InsanityBy/SmartPublicBathroom/README.md

# 智能公共浴室管理系统  

## 项目情况介绍  
本部分将从**项目背景**、**项目功能**、**系统框架**和**系统指标**四个方面对智能公共浴室管理系统项目进行简略介绍。您在阅读后，将对本项目有最基本的认识，可以根据您的需求决定本项目是否适用。如需进一步获取项目情况，您可查看以下文件:  
`Project\0_Document\OpeningReport_SmartPublicBathroom.md`  

### 项目背景  

### 项目功能  
### 系统框架  
### 系统指标  
## 使用要求及方法  
### 使用要求  
### 使用方法  
## 成品效果展示  
## 文件结构说明
- `Project`目录下包含项目的开发文件
    - `Document`项目开发总体设计方案
    - `ShowerTerminal`淋浴器终端的开发文件
        - `Enclosure`外壳设计
            - `Document`设计文档
            - `Project`项目文件
            - `Reference`参考资料
        - `Hardware`硬件设计
            - `Document`设计文档
            - `Schematic`原理图
            - `PCB`PCB设计
            - `Lirary`符号库、封装库和3D模型库
            - `Reference`参考资料和数据手册
        - `Software`软件设计
            - `Document`设计文档
            - `Library`各模块库文件
            - `Project`项目文件和主程序
            - `Reference`参考资料
    - `ShowerHost`淋浴间主机的开发文件
        - 内部文件结构同`ShowerTerminal`
    - `Image`项目文档中的所有图片
    - `Reference`总体设计引用的参考资料
- `Report`目录下包含项目的汇报文件
    - `OpeningReport`开题报告相关文件
        - `Document`报告文档
        - `Image`报告中所有图片
        - `Presentation`报告幻灯片
        - `Reference`报告引用的参考资料
    - `DesignReview`设计审查相关文件
        - `Document`报告文档
        - `Image`报告中所有图片
        - `Presentation`报告幻灯片
    - `MidtermReview`中期审查相关文件
    - `FinalReport`结题报告相关文件
    - `Upload`每阶段提交的压缩文件
