InsanityBy/SmartPublicBathroom/Project/1_ShowerTerminal/Hardware/0_Document/Power_Design.md

# 电源设计  

## 修改历史  
|版本|日期|说明|作者|  
|----|----|----|----|
|V1.0|2022年4月11日|创建电源设计|马博阳|  
|V1.1|2022年4月11日|修改电源设计，输出±5V|马博阳|  
|V1.2|2022年4月16日|修改电源设计需求，强调强弱电隔离|马博阳|  
|V1.3|2022年4月20日|修改原理图，增加指示灯|马博阳|  

## 设计需求  
1. 输入为市电：220VAC；  
2. 输出为3路电源：±5VDC和3.3VDC；  
3. 强电和弱电隔离；  
4. 可以在浴室环境下正常工作，保证设备安全。  

## 电源电路设计  
为保证浴室环境内的用电安全，电路设计分为两部分：第一部分为AC-DC模块，将220V交流电转换为±5V直流电，低于潮湿环境人体安全电压12V，这一部分设置在模块外，可单独布置在浴室外；第二部分为直流稳压，在淋浴器终端和淋浴间主机内，对±5V直流输入滤波，并将+5V直流转换为3.3V直流并稳压。  
考虑到AC-DC模块有一定的安全问题，直接采用LM旗舰店提供的现有模块`RH-30W+5V/-5V`，该模块电气参数符合需求，并且为隔离变压器，实现了强弱电隔离。  
AC-DC  
淋浴器终端和淋浴间主机电源部分设计如下， 220μF和0.1μF电容并联，实现对±5V电源的滤波和去耦；`TLV1117`将+5V输出稳压至3.3V。  
Control&Drive_Schematic
