InsanityBy/SmartPublicBathroom/Project/2_ShowerHost/Software/0_Document/ShowerHost_Interrupt.md

# 淋浴间主机中断配置  

## 修改历史  
|版本|日期|说明|作者|  
|----|----|----|----|
|V1.0|2022年5月11日|创建淋浴间主机中断配置|马博阳|  

1. 按键消抖定时器中断，优先级0 - 0
2. 按键中断，优先级1 - 0
3. ZigBee串口接收中断， 优先级2 - 0
4. WiFi串口接收中断，优先级2 - 0
5. ADC采样中断，优先级3 - 0
