InsanityBy/SmartPublicBathroom/Project/1_ShowerTerminal/Software/0_Document/ShowerTerminal_Interrupt.md

# 淋浴器终端中断配置  

## 修改历史  
|版本|日期|说明|作者|  
|----|----|----|----|
|V1.0|2022年5月11日|创建淋浴器终端中断配置|马博阳|  

1. 按键消抖定时器中断，优先级0 - 0
2. 按键中断，优先级1 - 0
3. ADC采样中断，优先级2 - 0
4. 红外接收头中断，优先级2 - 0
