InsanityBy/SmartPublicBathroom/Project/Image/Background.png

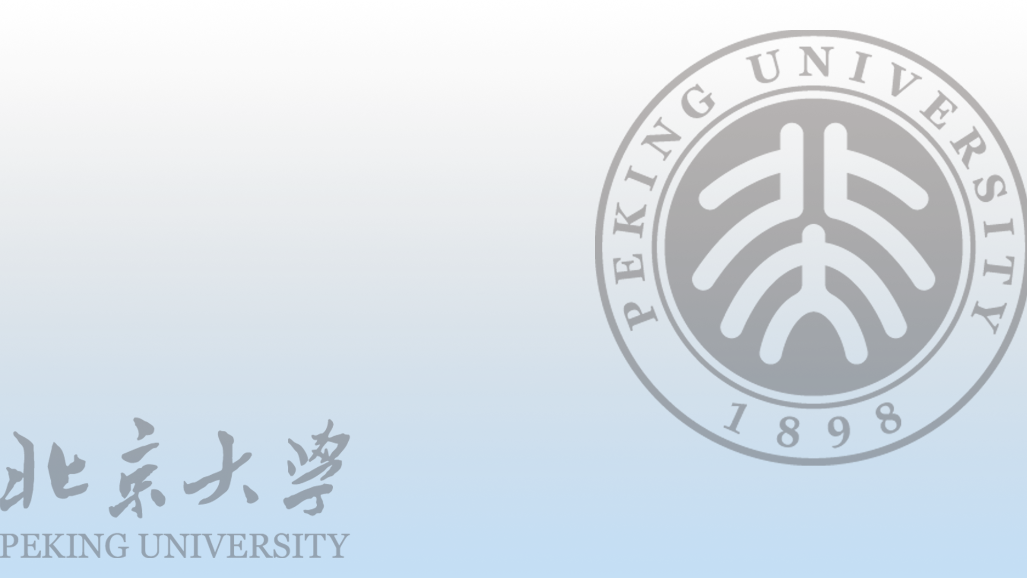
Project/Image/Background.png
