InsanityBy/SmartPublicBathroom/Project/0_Document/BOM.xlsx

序号 | 商品类型 | 商品名称 | 商品型号 | 封装格式 | 数量 | 总金额 | 商品编号 | 品牌
1 | 贴片电容(MLCC) | 100nF ±10% 50V | C0805B104K500NT | 0805 | 50 | ￥1.12 | C476766 | TORCH(火炬)
2 | 贴片型铝电解电容 | 220uF ±20% 10V | RVT1A221M0605 | SMD,6.3x5.4mm | 20 | ￥3.88 | C970694 | DMBJ(振宝佳)
3 | 贴片电容(MLCC) | 1uF ±20% 25V | TCC0805X5R105M250FT | 0805 | 50 | ￥1.80 | C713511 | CCTC(三环)
4 | 贴片电容(MLCC) | 47uF ±20% 6.3V | CL21A476MQYNNNG | 0805 | 10 | ￥2.30 | C913933 | SAMSUNG(三星)
5 | 贴片电容(MLCC) | 10uF ±10% 10V | CL21A106KPFNNNE | 0805 | 50 | ￥2.60 | C17024 | SAMSUNG(三星)
6 | 贴片电容(MLCC) | 20pF ±5% 100V | TCC0805COG200J101BT | 0805 | 50 | ￥2.49 | C696908 | CCTC(三环)
7 | 贴片电容(MLCC) | 15pF ±5% 50V | TCC0805COG150J500BT | 0805 | 50 | ￥1.54 | C376865 | CCTC(三环)
8 | 发光二极管 | 蓝灯 | NCD0805B2 | 0805 | 20 | ￥3.12 | C84259 | 国星光电
9 | 通用二极管 | 1kV 1A 1.1V@1A | 1N4007 | DO-41 | 20 | ￥2.27 | C2848132 | HORNBY ELECTRONIC(南通康比)
10 | 红外发射管 | F5发射管 Q等级 | DY-IR333C-A | Through Hole,P=2.54mm | 10 | ￥3.00 | C390046 | TONYU(东裕)
11 | 红外遥控接收头 | IRM-56384 | IRM-56384 | 插件 | 3 | ￥2.86 | C72048 | EVERLIGHT(台湾亿光)
12 | 温度传感器 | 数字温度圆线探头 | DS18B20A10 | 1M | 1 | ￥15.34 | C2938789 | UMW(友台半导体)
13 | 磁珠 | 30Ω@100MHz ±25% | FCM1608KF-300T07 | 0603 | 100 | ￥1.97 | C133930 | 台庆
14 | 环境光传感器 | 光敏传感器 | HLPT5I850HP25 | Through Hole | 5 | ￥3.38 | C559380 | JCHL(晶创和立)
15 | 三极管(BJT) | NPN 25V 500mA | S8050 | SOT-23(SOT-23-3) | 50 | ￥2.95 | C181158 | Hottech(合科泰)
16 | 光电三极管 | K等级 | DY-PT333-3B | ThroughHole | 10 | ￥3.52 | C396683 | TONYU(东裕)
17 | 功率继电器 | 功率继电器 10A250VAC | 973-5VDC-SL-A | 插件 | 3 | ￥6.17 | C396949 | NHLC(汇龙仓)
18 | 贴片电阻 | 1kΩ ±1% 125mW | AECR0805F1K00K9 | 0805 | 50 | ￥1.31 | C328385 | RESI(开步睿思）
19 | 贴片电阻 | 0Ω | FRC0805P000 TS | 0805 | 100 | ￥0.84 | C2907288 | FOJAN(富捷)
20 | 贴片电阻 | 1.8kΩ ±1% 0.125W | RMS10FT1801 | 0805 | 50 | ￥1.35 | C912582 | 台湾大毅
21 | 贴片电阻 | 100Ω ±5% 125mW | FRC0805J101 TS | 0805 | 100 | ￥0.84 | C2907294 | FOJAN(富捷)
22 | 贴片电阻 | 220Ω ±5% 1/8W | FRC0805J221TSD | 0805 | 100 | ￥0.80 | C2930259 | FOJAN(富捷)
23 | 贴片电阻 | 11kΩ ±5% 125mW | 0805W8J0113T5E | 0805 | 100 | ￥1.10 | C25614 | UNI-ROYAL(厚声)
24 | 贴片电阻 | 100kΩ ±5% 125mW | RC0805JR-07100KL | 0805 | 100 | ￥0.98 | C100049 | YAGEO(国巨)
25 | 贴片电阻 | 3.9kΩ ±5% 1/8W | FRC0805J392TS | 0805 | 100 | ￥0.86 | C2930268 | FOJAN(富捷)
26 | 贴片电阻 | 10kΩ ±5% 1/8W | FRC0805J103TS | 0805 | 100 | ￥0.95 | C2930231 | FOJAN(富捷)
27 | 贴片电阻 | 620Ω ±5% 1/8W | FRC0805J621 TSD | 0805 | 100 | ￥0.85 | C2933560 | FOJAN(富捷)
28 | 贴片电阻 | 91kΩ ±1% 1/8W | FRC0805F9102TS | 0805 | 100 | ￥1.09 | C2933509 | FOJAN(富捷)
29 | 贴片电阻 | 27kΩ ±5% 1/8W | FRC0805J273TS | 0805 | 100 | ￥0.84 | C2930263 | FOJAN(富捷)
30 | 贴片电阻 | 330kΩ ±5% 125mW | RS-05K334JT | 0805 | 100 | ￥0.88 | C294705 | FH(风华)
31 | 贴片电阻 | 9.1kΩ ±5% 125mW | FRC0805J912 TS | 0805 | 100 | ￥0.80 | C2907345 | FOJAN(富捷)
32 | 贴片电阻 | 8.2kΩ ±1% 1/8W | FRC0805F8201TS | 0805 | 100 | ￥1.02 | C2933503 | FOJAN(富捷)
33 | 贴片电阻 | 51kΩ ±5% 1/8W | FRC0805J513TS | 0805 | 100 | ￥0.80 | C2930300 | FOJAN(富捷)
34 | 贴片电阻 | 330Ω ±5% 1/8W | FRC0805J331TSD | 0805 | 100 | ￥0.85 | C2930274 | FOJAN(富捷)
35 | 线性稳压器(LDO) | Vin=5.5V Vout=3.3V 1A 75dB@(120Hz) | TLV1117LV33DCYR | SOT-223 | 2 | ￥4.42 | C15578 | TI(德州仪器)
36 | 精密运放 | TLV2374IDR | TLV2374IDR | SOIC-14_150mil | 2 | ￥22.36 | C29793 | TI(德州仪器)
37 | 湿敏/温湿度传感器 | 数字温湿度模块12mm*15.5mm*5.9mm | DHT21 | 插件 | 1 | ￥10.26 | C2880290 | HAIGU(广州海谷)
38 | 音频接口芯片 | WT588F08A-8S | WT588F08A-8S | SOP-8 | 2 | ￥15.08 | C2931176 | WT(唯创知音)
39 | ST(意法半导体) | STM32F303RBT6 | STM32F303RBT6 | LQFP-64_10x10x05P | 2 | ￥64.16 | C130453 | ST(意法半导体)
40 | 无源晶振 | 8MHZ ∞PF 20PPM | 49SAC08000∞2060 | HC-49S | 5 | ￥2.64 | C443528 | JGHC(晶光华)
41 | 无源晶振 | 32.768KHz 12.5PF 20ppm | DT-38 32.768KHz | DT-38 | 5 | ￥4.35 | C93228 | KDS大真空
