InsanityBy/SmartPublicBathroom/Project/2_ShowerHost/Hardware/0_Document/ShowerHost_BOM.xlsx

序号 | 数量 | 电路标号 | 规格/型号 | 封装 | 商品编号 | 附属配件 | 备注
1 | 20 | C1 | 100n | c0805 | C476766 | 无 | 已买
 |  | C5 | 100n | c0805 | C476766 | 无 | 已买
 |  | C7 | 100n | c0805 | C476766 | 无 | 已买
 |  | C8 | 100n | c0805 | C476766 | 无 | 已买
 |  | C11 | 100n | c0805 | C476766 | 无 | 已买
 |  | C12 | 100n | c0805 | C476766 | 无 | 已买
 |  | C13 | 100n | c0805 | C476766 | 无 | 已买
 |  | C14 | 100n | c0805 | C476766 | 无 | 已买
 |  | C15 | 100n | c0805 | C476766 | 无 | 已买
 |  | C16 | 100n | c0805 | C476766 | 无 | 已买
 |  | C17 | 100n | c0805 | C476766 | 无 | 已买
 |  | C19 | 100n | c0805 | C476766 | 无 | 已买
 |  | C21 | 100n | c0805 | C476766 | 无 | 已买
 |  | C23 | 100n | c0805 | C476766 | 无 | 已买
 |  | C26 | 100n | c0805 | C476766 | 无 | 已买
 |  | C27 | 100n | c0805 | C476766 | 无 | 已买
 |  | C28 | 100n | c0805 | C476766 | 无 | 已买
 |  | C29 | 100n | c0805 | C476766 | 无 | 已买
 |  | C30 | 100n | c0805 | C476766 | 无 | 已买
 |  | C33 | 100n | c0805 | C476766 | 无 | 已买
2 | 2 | C2 | 220u | c-220u | C970694 | 无 | 已买
 |  | C6 | 220u | c-220u | C970694 | 无 | 已买
3 | 6 | C3 | 1u | c0805 | C713511 | 无 | 已买
 |  | C4 | 1u | c0805 | C713511 | 无 | 已买
 |  | C9 | 1u | c0805 | C713511 | 无 | 已买
 |  | C10 | 1u | c0805 | C713511 | 无 | 已买
 |  | C22 | 1u | c0805 | C713511 | 无 | 已买
 |  | C25 | 1u | c0805 | C713511 | 无 | 已买
4 | 2 | C18 | 10u | c0805 | C17024 | 无 | 已买
 |  | C20 | 10u | c0805 | C17024 | 无 | 已买
5 | 1 | C24 | 2.2u | c0805 | C28234 | 无 | 未买
6 | 2 | C31 | 20pF | c0805 | C696908 | 无 | 已买
 |  | C32 | 20pF | c0805 | C696908 | 无 | 已买
7 | 2 | C34 | 15pF | c0805 | C376865 | 无 | 已买
 |  | C35 | 15pF | c0805 | C376865 | 无 | 已买
8 | 1 | D1 | +5V_ON | led0805-rd | C84259 | 无 | 已买
9 | 1 | D2 | -5V_ON | led0805-rd | C84259 | 无 | 已买
10 | 1 | D3 | 3V3_ON | led-th_bd3_0-p2_54-fd | C99772 | 无 | 未买
11 | 4 | D4 | 1N4007 | do-41_bd2_4-l4_7-p8_70-d0_6-rd | C2848132 | 无 | 已买
 |  | D5 | 1N4007 | do-41_bd2_4-l4_7-p8_70-d0_6-rd | C2848132 | 无 | 已买
 |  | D7 | 1N4007 | do-41_bd2_4-l4_7-p8_70-d0_6-rd | C2848132 | 无 | 已买
 |  | D9 | 1N4007 | do-41_bd2_4-l4_7-p8_70-d0_6-rd | C2848132 | 无 | 已买
12 | 1 | D6 | FAN_ON | led-th_bd3_0-p2_54-fd | C181864 | 无 | 未买
13 | 1 | D8 | LIGHT_ON | led-th_bd3_0-p2_54-fd | C181864 | 无 | 未买
14 | 1 | D10 | SPEAKER_ON | led0805-rd | C84259 | 无 | 已买
15 | 1 | D11 | ZigBee_LINK | led0805-rd | C84259 | 无 | 已买
16 | 1 | D12 | ZigBee_CMD | led0805-rd | C84259 | 无 | 已买
17 | 1 | D13 | SOCKET1 | led0805-rd | C84259 | 无 | 已买
18 | 1 | D14 | SOCKET2 | led0805-rd | C84259 | 无 | 已买
19 | 1 | J1 | RH-30W_PORT | conn-th_3p-p2_50_hx25003-3wap | C442327 | 无 | 未买
20 | 1 | J2 | FAN_PORT | conn-th_p5_00_kf127-5_0-2p | C474904 | 无 | 未买
21 | 1 | J3 | LIGHT_PORT | conn-th_p5_00_kf127-5_0-2p | C474904 | 无 | 未买
22 | 1 | J4 | LCD_PORT | hdr-th_4p-p2_54-v-f | C2718488 | 显示屏淘宝已买 | 未买
23 | 1 | J5 | SPEAKER_PORT | hdr-th_2p-p2_54-v-f | 无 | 扬声器淘宝已买 | 焊接
24 | 1 | J6 | SWD_PORT | hdr-th_4p-p2_54-v-f | C2718488 | 调试器已有 | 未买
25 | 1 | L1 | FCM1608 | l0603 | C133930 | 无 | 已买
26 | 1 | Q1 | HLPT5I850HP25 | led-th_bd5_0_blue | C559380 | 无 | 已买
27 | 2 | Q2 | S8050 | sot-23-3_l2_9-w1_6-p1_90-ls2_8-br | C181158 | 无 | 已买
 |  | Q3 | S8050 | sot-23-3_l2_9-w1_6-p1_90-ls2_8-br | C181158 | 无 | 已买
28 | 2 | RL1 | 973-5VDC-SL-A | relay-th_973-xxvdc-sl-a | C396949 | 无 | 已买
 |  | RL2 | 973-5VDC-SL-A | relay-th_973-xxvdc-sl-a | C396949 | 无 | 已买
29 | 5 | R1 | 0 | r0805 | C2907288 | 无 | 已买
 |  | R33 | 0 | r0805 | C2907288 | 无 | 已买
 |  | R36 | 0 | r0805 | C2907288 | 无 | 已买
 |  | R38 | 0 | r0805 | C2907288 | 无 | 已买
 |  | R39 | 0 | r0805 | C2907288 | 无 | 已买
30 | 11 | R2 | 1k | r0805 | C328385 | 无 | 已买
 |  | R3 | 1k | r0805 | C328385 | 无 | 已买
 |  | R4 | 1k | r0805 | C328385 | 无 | 已买
 |  | R15 | 1k | r0805 | C328385 | 无 | 已买
 |  | R18 | 1k | r0805 | C328385 | 无 | 已买
 |  | R21 | 1k | r0805 | C328385 | 无 | 已买
 |  | R22 | 1k | r0805 | C328385 | 无 | 已买
 |  | R26 | 1k | r0805 | C328385 | 无 | 已买
 |  | R27 | 1k | r0805 | C328385 | 无 | 已买
 |  | R29 | 1k | r0805 | C328385 | 无 | 已买
 |  | R32 | 1k | r0805 | C328385 | 无 | 已买
31 | 12 | R5 | 10k | r0805 | C2930231 | 无 | 已买
 |  | R6 | 10k | r0805 | C2930231 | 无 | 已买
 |  | R7 | 10k | r0805 | C2930231 | 无 | 已买
 |  | R12 | 10k | r0805 | C2930231 | 无 | 已买
 |  | R13 | 10k | r0805 | C2930231 | 无 | 已买
 |  | R14 | 10k | r0805 | C2930231 | 无 | 已买
 |  | R24 | 10k | r0805 | C2930231 | 无 | 已买
 |  | R25 | 10k | r0805 | C2930231 | 无 | 已买
 |  | R28 | 10k | r0805 | C2930231 | 无 | 已买
 |  | R30 | 10k | r0805 | C2930231 | 无 | 已买
 |  | R31 | 10k | r0805 | C2930231 | 无 | 已买
 |  | R34 | 10k | r0805 | C2930231 | 无 | 已买
32 | 1 | R8 | 91k | r0805 | C2933509 | 无 | 已买
33 | 1 | R9 | 27k | r0805 | C2930263 | 无 | 已买
34 | 1 | R10 | 330k | r0805 | C294705 | 无 | 已买
35 | 1 | R11 | 9.1k | r0805 | C2907345 | 无 | 已买
36 | 2 | R16 | 8.2k | r0805 | C2933503 | 无 | 已买
 |  | R19 | 8.2k | r0805 | C2933503 | 无 | 已买
37 | 2 | R17 | 51k | r0805 | C2930300 | 无 | 已买
 |  | R20 | 51k | r0805 | C2930300 | 无 | 已买
38 | 1 | R23 | 330 | r0805 | C2930274 | 无 | 已买
39 | 1 | R35 | 100k | r0805 | C100049 | 无 | 已买
40 | 1 | R37 | 220 | r0805 | C2930259 | 无 | 已买
41 | 1 | SW1 | REPAIR | sw-th_4p-l6_0-w6_0-p4_50-ls6_5 | C393949 | 按键帽淘宝已买 | 未买
42 | 1 | SW2 | HELP | sw-th_4p-l6_0-w6_0-p4_50-ls6_5 | C393949 | 按键帽淘宝已买 | 未买
43 | 1 | SW3 | WiFi_RST | sw-smd_4p-l5_1-w5_1-p3_70-ls6_5-tl-2 | 无 | 无 | 已买
44 | 1 | SW4 | ZigBee_RST | sw-smd_4p-l5_1-w5_1-p3_70-ls6_5-tl-2 | 无 | 无 | 已买
45 | 1 | SW5 | ZigBee_WK | sw-smd_4p-l5_1-w5_1-p3_70-ls6_5-tl-2 | 无 | 无 | 已买
46 | 1 | SW6 | MCU_NRST | sw-smd_4p-l5_1-w5_1-p3_70-ls6_5-tl-2 | 无 | 无 | 已买
47 | 1 | U1 | TLV1117LV33 | sot-223_l6_7-w3_5-p2_30-br | C15578 | 无 | 已买
48 | 1 | U2 | TLV2374 | soic-14_l8_7-w3_9-p1_27-ls6_0-bl | C29793 | 无 | 已买
49 | 1 | U3 | DHT21 | nil-namemapper | C2880290 | 无 | 已买
50 | 1 | U4 | WT588F08A-8S | sop-8_l4_9-w3_9-p1_27-ls6_0-bl | C2931176 | 无 | 已买
51 | 1 | U5 | A51-C2G4A20S1a | s24-pad | 无 | 无 | 已买
52 | 1 | U6 | A40-C2G4A04S1a | s24-pad | 无 | 无 | 已买
53 | 1 | U7 | STM32F401RE | LQFP64-10x10mm | 无 | 无 | 实验室
54 | 1 | Y1 | 8MHz | osc-th_l11_1-w4_7-p4_88 | C443528 | 无 | 已买
55 | 1 | Y2 | 32.768kHz | osc-th_bd3_0-p1_10-d0_4 | C93228 | 无 | 已买
