InsanityBy/SmartPublicBathroom/Project/1_ShowerTerminal/Hardware/3_Library/3D/TLV2374.stp

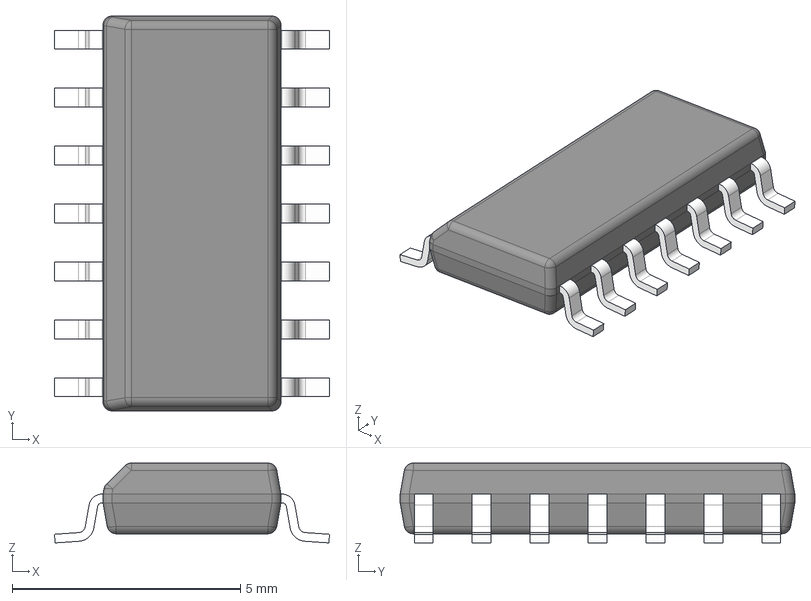
[picture p56: CAD file, 2022-04-16]
Project/1_ShowerTerminal/Hardware/3_Library/3D/TLV2374.stp
6.03 x 8.65 x 1.75 mm
BODY-SO
LEAD-SO x 14
PIN1-ID
