InsanityBy/SmartPublicBathroom/Project/1_ShowerTerminal/Hardware/3_Library/Footprint/ul_STM32F401RET6/LQFP64-10x10mm.step

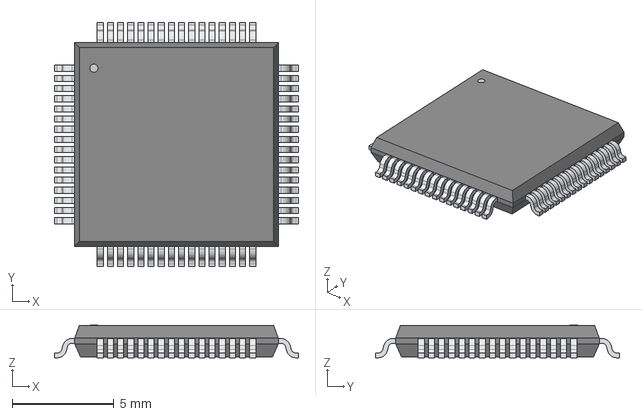
[picture p57: CAD file, 2022-04-20]
Project/1_ShowerTerminal/Hardware/3_Library/Footprint/ul_STM32F401RET6/LQFP64-10x10mm.step
12.0 x 12.0 x 1.60 mm
