InsanityBy/SmartPublicBathroom/Project/1_ShowerTerminal/Hardware/Reference/RC522MINI/RC522MINI_Mechanical/RC522MINI_Dimension.dxf

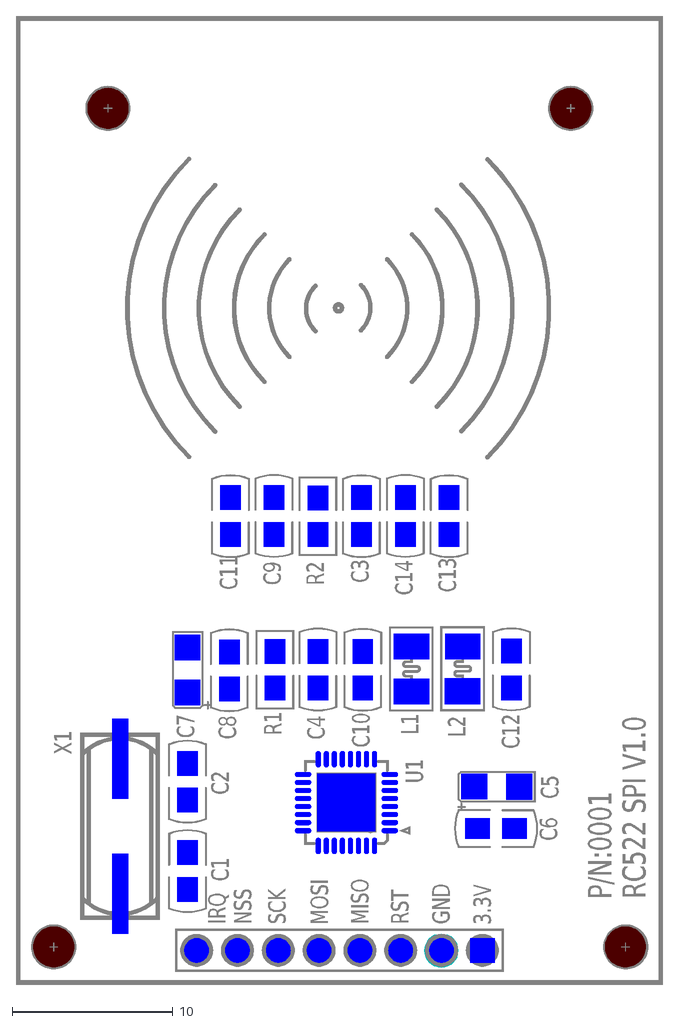
[picture p58: CAD file, 2022-04-18]
Project/1_ShowerTerminal/Hardware/Reference/RC522MINI/RC522MINI_Mechanical/RC522MINI_Dimension.dxf
P/N:0001
RC522 SPI V1.0
IRQ
NSS
SCK
MOSI
MISO
RST
GND
3.3V
C1
C10
C11
C12
C13
C14
C2
C3
C4
C5
C6
C7
C8
C9
L1
L2
R1
R2
U1
X1
