InsanityBy/SmartPublicBathroom/Project/2_ShowerHost/Hardware/3_Library/3D/TLV1117LV.stp

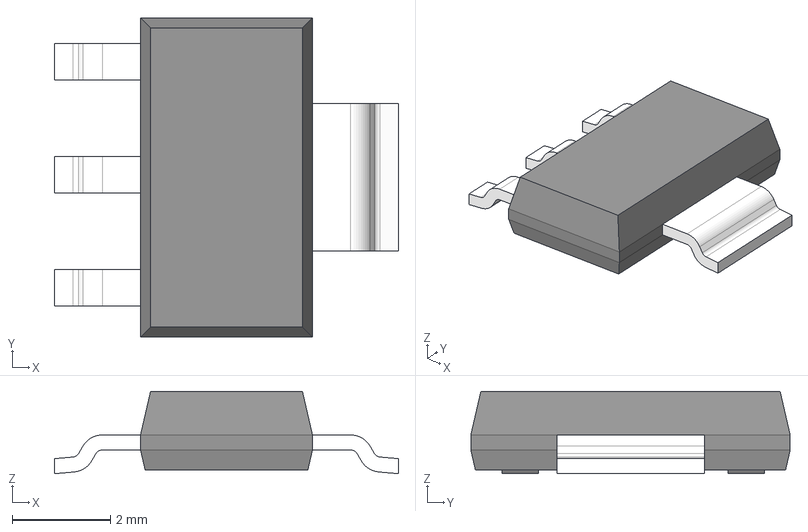
[picture p59: CAD file, 2022-04-16]
Project/2_ShowerHost/Hardware/3_Library/3D/TLV1117LV.stp
7.00 x 6.50 x 1.68 mm
BODY-SOT
LEAD-SOT x 3
LEAD-SOT-WIDE
PIN1-ID
