InsanityBy/SmartPublicBathroom/Project/1_ShowerTerminal/Hardware/Reference/RC522MINI/RC522MINI_Mechanical/RC522MINI_CAD.dxf

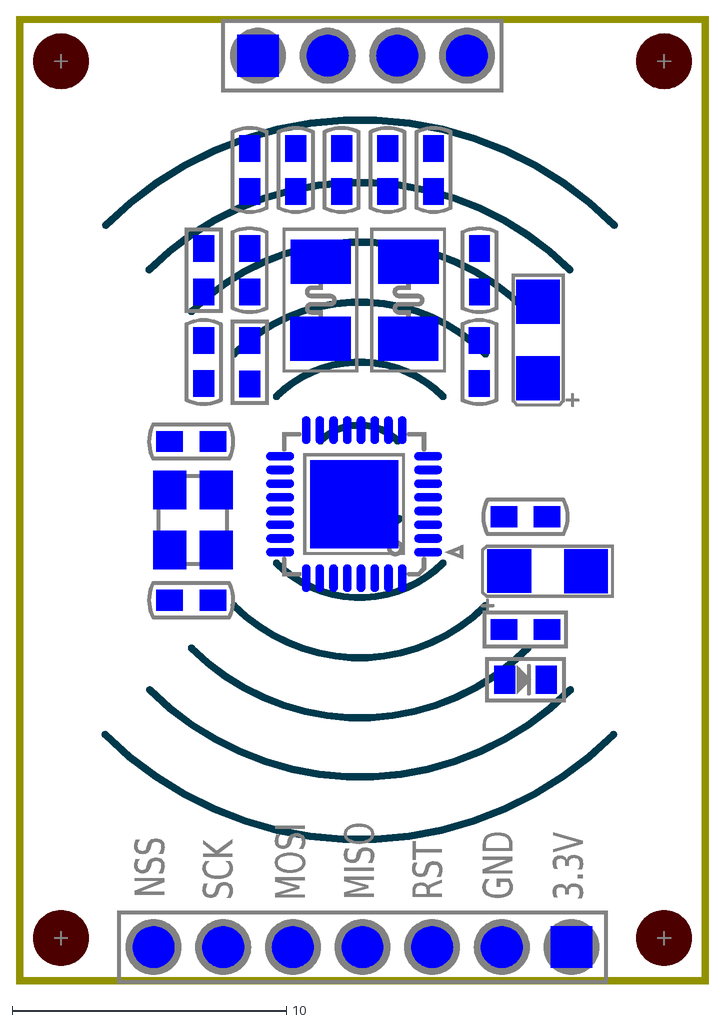
[picture p60: CAD file, 2022-04-18]
Project/1_ShowerTerminal/Hardware/Reference/RC522MINI/RC522MINI_Mechanical/RC522MINI_CAD.dxf
NSS
SCK
MOSI
MISO
RST
GND
3.3V
