InsanityBy/SmartPublicBathroom/(list of files, cad)

Other CAD files:
Project/1_ShowerTerminal/Hardware/3_Library/Footprint/2x2p_2.54mm_bent/conn-th_4p-p2_54_dealon_dw254w-22-04-85.psm
Project/1_ShowerTerminal/Hardware/3_Library/Footprint/3p_2.54mm_bent/hdr-th_3p-p2_54-h-f-w8_6.psm
Project/1_ShowerTerminal/Hardware/3_Library/Footprint/3p_2.5mm_XH/conn-th_3p-p2_50_hx25003-3wap.psm
Project/1_ShowerTerminal/Hardware/3_Library/Footprint/BJT/sot-23-3_l2_9-w1_6-p1_90-ls2_8-br.psm
Project/1_ShowerTerminal/Hardware/3_Library/Footprint/C_220u/cap-smd_bd6_3-l6_6-w6_6-ls7_2-r-rd.psm
Project/1_ShowerTerminal/Hardware/3_Library/Footprint/diode/do-41_bd2_4-l4_7-p8_70-d0_6-rd.psm
Project/1_ShowerTerminal/Hardware/3_Library/Footprint/ldo/sot-223_l6_7-w3_5-p2_30-br.psm
Project/1_ShowerTerminal/Hardware/3_Library/Footprint/led0805/led0805-rd.psm
Project/1_ShowerTerminal/Hardware/3_Library/Footprint/led_plug/led-th_bd3_0-p2_54-fd.psm
Project/1_ShowerTerminal/Hardware/3_Library/Footprint/lib_footprint/c-220u.psm
Project/1_ShowerTerminal/Hardware/3_Library/Footprint/lib_footprint/c0805.psm
Project/1_ShowerTerminal/Hardware/3_Library/Footprint/lib_footprint/conn-th_3p-p2_50_hx25003-3wap.psm
Project/1_ShowerTerminal/Hardware/3_Library/Footprint/lib_footprint/conn-th_4p-p2_54_dealon_dw254w-22-04-85.psm
Project/1_ShowerTerminal/Hardware/3_Library/Footprint/lib_footprint/conn-th_p5_00_kf127-5_0-2p.psm
Project/1_ShowerTerminal/Hardware/3_Library/Footprint/lib_footprint/do-41_bd2_4-l4_7-p8_70-d0_6-rd.psm
Project/1_ShowerTerminal/Hardware/3_Library/Footprint/lib_footprint/hdr-th_2p-p2_54-v-f.psm
Project/1_ShowerTerminal/Hardware/3_Library/Footprint/lib_footprint/hdr-th_3p-p2_54-h-f-w8_6.psm
Project/1_ShowerTerminal/Hardware/3_Library/Footprint/lib_footprint/hdr-th_3p-p2_54-v-f.psm
Project/1_ShowerTerminal/Hardware/3_Library/Footprint/lib_footprint/hdr-th_4p-p2_54-v-f.psm
Project/1_ShowerTerminal/Hardware/3_Library/Footprint/lib_footprint/hdr-th_8p-p2_54-v-f-1.psm
Project/1_ShowerTerminal/Hardware/3_Library/Footprint/lib_footprint/key-th_4p-l6_2-w6_2-p4_50-ls6_5.psm
Project/1_ShowerTerminal/Hardware/3_Library/Footprint/lib_footprint/l0603.psm
Project/1_ShowerTerminal/Hardware/3_Library/Footprint/lib_footprint/led-th_bd3_0-p2_54-fd.psm
Project/1_ShowerTerminal/Hardware/3_Library/Footprint/lib_footprint/led-th_bd5_0_blue.psm
Project/1_ShowerTerminal/Hardware/3_Library/Footprint/lib_footprint/led-th_bd5_9-p2_54-fd.psm
Project/1_ShowerTerminal/Hardware/3_Library/Footprint/lib_footprint/led-th_bd6_2-p2_54-rd.psm
Project/1_ShowerTerminal/Hardware/3_Library/Footprint/lib_footprint/led0805-rd.psm
Project/1_ShowerTerminal/Hardware/3_Library/Footprint/lib_footprint/lqfp64-10x10mm.psm
Project/1_ShowerTerminal/Hardware/3_Library/Footprint/lib_footprint/nil-namemapper.psm
Project/1_ShowerTerminal/Hardware/3_Library/Footprint/lib_footprint/opto-th_irm-56384.psm
Project/1_ShowerTerminal/Hardware/3_Library/Footprint/lib_footprint/osc-th_bd3_0-p1_10-d0_4.psm
Project/1_ShowerTerminal/Hardware/3_Library/Footprint/lib_footprint/osc-th_l11_1-w4_7-p4_88.psm
Project/1_ShowerTerminal/Hardware/3_Library/Footprint/lib_footprint/r0805.psm
Project/1_ShowerTerminal/Hardware/3_Library/Footprint/lib_footprint/relay-th_973-xxvdc-sl-a.psm
Project/1_ShowerTerminal/Hardware/3_Library/Footprint/lib_footprint/s24-pad.psm
Project/1_ShowerTerminal/Hardware/3_Library/Footprint/lib_footprint/soic-14_l8_7-w3_9-p1_27-ls6_0-bl.psm
Project/1_ShowerTerminal/Hardware/3_Library/Footprint/lib_footprint/sop-8_l4_9-w3_9-p1_27-ls6_0-bl.psm
Project/1_ShowerTerminal/Hardware/3_Library/Footprint/lib_footprint/sot-223_l6_7-w3_5-p2_30-br.psm
Project/1_ShowerTerminal/Hardware/3_Library/Footprint/lib_footprint/sot-23-3_l2_9-w1_6-p1_90-ls2_8-br.psm
Project/1_ShowerTerminal/Hardware/3_Library/Footprint/lib_footprint/sw-smd_4p-l5_1-w5_1-p3_70-ls6_5-tl-2.psm
Project/1_ShowerTerminal/Hardware/3_Library/Footprint/lib_footprint/sw-th_4p-l6_0-w6_0-p4_50-ls6_5.psm
Project/1_ShowerTerminal/Hardware/3_Library/Footprint/opamp/soic-14_l8_7-w3_9-p1_27-ls6_0-bl.psm
Project/1_ShowerTerminal/Hardware/3_Library/Footprint/phototriode/led-th_bd6_2-p2_54-rd.psm
Project/1_ShowerTerminal/Hardware/3_Library/Footprint/pushbutton_big/key-th_4p-l6_2-w6_2-p4_50-ls6_5.psm
Project/1_ShowerTerminal/Hardware/3_Library/Footprint/pushbutton_little/sw-smd_4p-l5_1-w5_1-p3_70-ls6_5-tl-2.psm
Project/1_ShowerTerminal/Hardware/3_Library/Footprint/pushbutton_new/sw-th_4p-l6_0-w6_0-p4_50-ls6_5.psm
Project/1_ShowerTerminal/Hardware/3_Library/Footprint/ray_emit/led-th_bd5_9-p2_54-fd.psm
Project/1_ShowerTerminal/Hardware/3_Library/Footprint/relay/relay-th_973-xxvdc-sl-a.psm
Project/1_ShowerTerminal/Hardware/3_Library/Footprint/wifi_zigbee/s24-pad.psm
Project/2_ShowerHost/Hardware/3_Library/Footprint/2x2p_2.54mm_bent/conn-th_4p-p2_54_dealon_dw254w-22-04-85.psm
Project/2_ShowerHost/Hardware/3_Library/Footprint/3p_2.54mm_bent/hdr-th_3p-p2_54-h-f-w8_6.psm
Project/2_ShowerHost/Hardware/3_Library/Footprint/3p_2.5mm_XH/conn-th_3p-p2_50_hx25003-3wap.psm
Project/2_ShowerHost/Hardware/3_Library/Footprint/led_plug/led-th_bd3_0-p2_54-fd.psm
Project/2_ShowerHost/Hardware/3_Library/Footprint/lib_footprint/c-220u.psm
Project/2_ShowerHost/Hardware/3_Library/Footprint/lib_footprint/c0805.psm
Project/2_ShowerHost/Hardware/3_Library/Footprint/lib_footprint/conn-th_3p-p2_50_hx25003-3wap.psm
Project/2_ShowerHost/Hardware/3_Library/Footprint/lib_footprint/conn-th_4p-p2_54_dealon_dw254w-22-04-85.psm
Project/2_ShowerHost/Hardware/3_Library/Footprint/lib_footprint/conn-th_p5_00_kf127-5_0-2p.psm
Project/2_ShowerHost/Hardware/3_Library/Footprint/lib_footprint/do-41_bd2_4-l4_7-p8_70-d0_6-rd.psm
Project/2_ShowerHost/Hardware/3_Library/Footprint/lib_footprint/hdr-th_2p-p2_54-v-f.psm
Project/2_ShowerHost/Hardware/3_Library/Footprint/lib_footprint/hdr-th_3p-p2_54-h-f-w8_6.psm
Project/2_ShowerHost/Hardware/3_Library/Footprint/lib_footprint/hdr-th_3p-p2_54-v-f.psm
Project/2_ShowerHost/Hardware/3_Library/Footprint/lib_footprint/hdr-th_4p-p2_54-v-f.psm
Project/2_ShowerHost/Hardware/3_Library/Footprint/lib_footprint/hdr-th_8p-p2_54-v-f-1.psm
Project/2_ShowerHost/Hardware/3_Library/Footprint/lib_footprint/key-th_4p-l6_2-w6_2-p4_50-ls6_5.psm
Project/2_ShowerHost/Hardware/3_Library/Footprint/lib_footprint/l0603.psm
Project/2_ShowerHost/Hardware/3_Library/Footprint/lib_footprint/led-th_bd3_0-p2_54-fd.psm
Project/2_ShowerHost/Hardware/3_Library/Footprint/lib_footprint/led-th_bd5_0_blue.psm
Project/2_ShowerHost/Hardware/3_Library/Footprint/lib_footprint/led-th_bd5_9-p2_54-fd.psm
Project/2_ShowerHost/Hardware/3_Library/Footprint/lib_footprint/led-th_bd6_2-p2_54-rd.psm
Project/2_ShowerHost/Hardware/3_Library/Footprint/lib_footprint/led0805-rd.psm
Project/2_ShowerHost/Hardware/3_Library/Footprint/lib_footprint/lqfp64-10x10mm.psm
Project/2_ShowerHost/Hardware/3_Library/Footprint/lib_footprint/nil-namemapper.psm
Project/2_ShowerHost/Hardware/3_Library/Footprint/lib_footprint/opto-th_irm-56384.psm
Project/2_ShowerHost/Hardware/3_Library/Footprint/lib_footprint/osc-th_bd3_0-p1_10-d0_4.psm
Project/2_ShowerHost/Hardware/3_Library/Footprint/lib_footprint/osc-th_l11_1-w4_7-p4_88.psm
Project/2_ShowerHost/Hardware/3_Library/Footprint/lib_footprint/r0805.psm
Project/2_ShowerHost/Hardware/3_Library/Footprint/lib_footprint/relay-th_973-xxvdc-sl-a.psm
Project/2_ShowerHost/Hardware/3_Library/Footprint/lib_footprint/s24-pad.psm
Project/2_ShowerHost/Hardware/3_Library/Footprint/lib_footprint/soic-14_l8_7-w3_9-p1_27-ls6_0-bl.psm
Project/2_ShowerHost/Hardware/3_Library/Footprint/lib_footprint/sop-8_l4_9-w3_9-p1_27-ls6_0-bl.psm
Project/2_ShowerHost/Hardware/3_Library/Footprint/lib_footprint/sot-223_l6_7-w3_5-p2_30-br.psm
Project/2_ShowerHost/Hardware/3_Library/Footprint/lib_footprint/sot-23-3_l2_9-w1_6-p1_90-ls2_8-br.psm
Project/2_ShowerHost/Hardware/3_Library/Footprint/lib_footprint/sw-smd_4p-l5_1-w5_1-p3_70-ls6_5-tl-2.psm
Project/2_ShowerHost/Hardware/3_Library/Footprint/lib_footprint/sw-th_4p-l6_0-w6_0-p4_50-ls6_5.psm
Project/2_ShowerHost/Hardware/3_Library/Footprint/phototriode/led-th_bd6_2-p2_54-rd.psm
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
