InsanityBy/SmartPublicBathroom/Project/0_Document/UserManual.md

# 公共浴室智能管理系统使用说明书  
## 修改历史  
|版本|日期|说明|作者|  
|----|----|----|----|
|V1.0|2022年4月4日|创建使用说明书，完成使用说明书大纲的编写，完成“产品介绍”部分的编写，|马博阳|  
## 产品介绍  
### 产品特性  
- 12V直流或220V交流供电  
- 用户预约，实时查看使用情况  
- 管理系统可视化数据展示  
- 分别为用户和管理者提供专用微信小程序  
- 精确环境温度、环境湿度、环境光照检测  
- 精确水流温度、水流量检测  
- 智能通风、照明控制  
- 物品遗落提示  
- 0.91寸单色OLED屏显示  
- 语音提示  
- 支持NFC卡片刷卡出水或单独水流控制  
- 双层防水，强弱电隔离  
- 安装方便，管理、调试简单  
- 基于ZigBee和WiFi的无线数据传输  
### 功能概述  
- 淋浴器基本功能：用户刷卡出水，计时/计量收费  
- 淋浴器信息展示：当前时间、卡内余额、水流温度、用户名、本次消费信息和淋浴器状态信息  
- 淋浴器语音提示：物品遗落、接近预约时间结束、接近供水时间结束等场景语音提示  
- 检测浴室内温度、湿度及亮度，智能控制灯光与换气扇  
- 用户可通过手机预约洗澡时段，查看浴室当前使用情况和人流量分析，查看预估等待时间，检测是否按时到达使用；  
- 统计浴室使用情况，为个人提供建议洗澡时间，帮助管理者设置供水时间；  
- 统计水温、用水量，为管理者提供设置供水时间、水量、水温的建议；  
- 遗落物品检测及报警提示；  
- 主动求助、报修功能。  
### 应用场景  
- 公共浴室  
- 校园宿舍  
- 公寓  
## 产品组成  
本产品由淋浴器终端、淋浴间主机和云服务平台组成。  
## 功能详细说明  
## 使用说明  
### 淋浴器终端  
#### 安装  
#### 配置  
#### 使用  
#### 调试  
### 淋浴间主机  
#### 安装  
#### 配置  
#### 使用  
#### 调试  
### 云服务平台  
#### 安装和注册  
#### 配置  
#### 使用  
#### 调试  
## 注意事项
