InsanityBy/SmartPublicBathroom/Project/1_ShowerTerminal/Hardware/3_Library/Footprint/C_220u/stepFacetFiles4Map/stepFileInfo.txt

#STEP_FILE ! FILE_SIZE ! MOD_TIME

0805.step ! 57849 ! 1568096060
0603.step ! 57899 ! 1568096060
