InsanityBy/SmartPublicBathroom/Project/1_ShowerTerminal/Hardware/3_Library/Footprint/ul_STM32F401RET6/stepFacetFiles4Map/stepFileInfo.txt

#STEP_FILE ! FILE_SIZE ! MOD_TIME

LQFP64-10x10mm.step ! 1109549 ! 1650269910
