InsanityBy/SmartPublicBathroom/(list of files, drawings)

Other design files:
Project/1_ShowerTerminal/Hardware/1_Schematic/SHOWERTERMINAL.DSN
Project/1_ShowerTerminal/Hardware/1_Schematic/showerterminal.opj
Project/1_ShowerTerminal/Hardware/3_Library/Symbol/COMMUNICATE.OLB
Project/1_ShowerTerminal/Hardware/3_Library/Symbol/DS18B20.OLB
Project/1_ShowerTerminal/Hardware/3_Library/Symbol/IR-56384.OLB
Project/1_ShowerTerminal/Hardware/3_Library/Symbol/MYTITLE.OLB
Project/1_ShowerTerminal/Hardware/3_Library/Symbol/ST_MCU.OLB
Project/1_ShowerTerminal/Hardware/3_Library/Symbol/TLV1117LV.OLB
Project/1_ShowerTerminal/Hardware/3_Library/Symbol/TLV2374.OLB
Project/1_ShowerTerminal/Hardware/3_Library/Symbol/WT588F08A-8S.OLB
Project/2_ShowerHost/Hardware/1_Schematic/SHOWERHOST.DSN
Project/2_ShowerHost/Hardware/1_Schematic/showerhost.opj
Project/2_ShowerHost/Hardware/3_Library/Symbol/COMMUNICATE.OLB
Project/2_ShowerHost/Hardware/3_Library/Symbol/DHT21.OLB
Project/2_ShowerHost/Hardware/3_Library/Symbol/MYTITLE.OLB
Project/2_ShowerHost/Hardware/3_Library/Symbol/ST_MCU.OLB
Project/2_ShowerHost/Hardware/3_Library/Symbol/TLV1117LV.OLB
Project/2_ShowerHost/Hardware/3_Library/Symbol/TLV2374.OLB
Project/2_ShowerHost/Hardware/3_Library/Symbol/WT588F08A-8S.OLB
