InsanityBy/SmartPublicBathroom/Project/1_ShowerTerminal/Software/1_Library/TemperatureSensor.h

/**
 ******************************************************************************
 * @file    TemperatureSensor.h
 * @author  Ma Boyang
 * @version V1.0
 * @date    2022.5.6
 * @brief   This file contains all the functions prototypes for the temperature
 *          sensor library.(For shower terminal.)
 ******************************************************************************
 */

/* Define to prevent recursive inclusion -------------------------------------*/
#ifndef __TEMPERATURESENSOR_H
#define __TEMPERATURESENSOR_H

#ifdef __cplusplus
extern "C"
{
#endif

/* Includes ------------------------------------------------------------------*/
#include "stm32f4xx.h"

/* Exported types ------------------------------------------------------------*/
/* Exported constants --------------------------------------------------------*/
/* Exported macro ------------------------------------------------------------*/
/* Exported functions --------------------------------------------------------*/
uint8_t TemperatureSensor_Init(void);
void Sensor_Convert(void);
float Sensor_GetTemperature(void);

#ifdef __cplusplus
}
#endif

#endif

/***********************************END OF FILE********************************/
