InsanityBy/SmartPublicBathroom/Project/1_ShowerTerminal/Software/2_Project/User/main.h

/**
 ******************************************************************************
 * @file    main.h
 * @author  Ma Boyang
 * @version V1.0
 * @date    2022.5.7
 * @brief   Header for main.c module.(For shower terminal.)
 ******************************************************************************
 */

/* Define to prevent recursive inclusion -------------------------------------*/
#ifndef __MAIN_H
#define __MAIN_H

/* Includes ------------------------------------------------------------------*/
#include "stm32f4xx.h"
#include "UserLibrary.h"

/* Exported types ------------------------------------------------------------*/
/* Exported constants --------------------------------------------------------*/
/* Exported macro ------------------------------------------------------------*/
/* Exported functions ------------------------------------------------------- */

#endif

/***********************************END OF FILE********************************/
