InsanityBy/SmartPublicBathroom/Project/2_ShowerHost/Software/1_Library/SignalOutput.h

/**
 ******************************************************************************
 * @file    SignalOutput.h
 * @author  Ma Boyang
 * @version V1.0
 * @date    2022.5.8
 * @brief   This file contains all the functions prototypes to control fan, 
 *          light.(For shower host.)
 ******************************************************************************
 */

/* Define to prevent recursive inclusion -------------------------------------*/
#ifndef __SIGNALOUTPUT_H
#define __SIGNALOUTPUT_H

#ifdef __cplusplus
extern "C"
{
#endif

/* Includes ------------------------------------------------------------------*/
#include "stm32f4xx.h"

/* Exported types ------------------------------------------------------------*/
/* Exported constants --------------------------------------------------------*/
/* Exported macro ------------------------------------------------------------*/
/* Exported functions --------------------------------------------------------*/
void SignalOutput_Init(void);
void Fan_Start(void);
void Fan_Stop(void);
uint8_t Fan_GetState(void);
void Light_Start(void);
void Light_Stop(void);
uint8_t Light_GetState(void);

#ifdef __cplusplus
}
#endif

#endif

/***********************************END OF FILE********************************/
