InsanityBy/SmartPublicBathroom/Project/2_ShowerHost/Software/1_Library/WiFi.h

/**
 ******************************************************************************
 * @file    WiFi.h
 * @author  Ma Boyang
 * @version V1.0
 * @date    2022.5.19
 * @brief   This file contains all the functions prototypes for communicata by
 *          WiFi.(For shower host.)
 ******************************************************************************
 */

/* Define to prevent recursive inclusion -------------------------------------*/
#ifndef __WIFI_H
#define __WIFI_H

#ifdef __cplusplus
extern "C"
{
#endif

/* Includes ------------------------------------------------------------------*/
#include "stm32f4xx.h"

/* Exported types ------------------------------------------------------------*/
/* Exported constants --------------------------------------------------------*/
/* Exported macro ------------------------------------------------------------*/
// AT Command
#define WiFi_Recovery "AT+UT_RECOVERY\r\n"
#define WiFi_DeviceReset "AT+UT_RESET\r\n"
#define WiFi_EchoDisable "AT+UT_RESHOW=DISABLE\r\n"
#define WiFi_Version "AT+UT_VER=?\r\n"

#define WiFi_WorkMode "AT+UT_WKMODE="
#define WiFi_WorkModeAT "CMD"
#define WiFi_WorkModeTransparent "TCPUDP"

#define WiFi_WiFiConfig "AT+WIFI="
#define WiFi_WiFiModeSTA "STA"
#define WiFi_WiFiModeAP "AP"

#define WiFi_Socket1EN "AT+ETH_CH1EN="
#define WiFi_Socket2EN "AT+ETH_CH2EN="
#define WiFi_Enable "ENABLE"
#define WiFi_Disable "DISABLE"

#define WiFi_Socket1Config "AT+ETH_CH1P="
#define WiFi_Socket2Config "AT+ETH_CH2P="

#define WiFi_Socket1Heart "AT+ETH_CH1HTP="
#define WiFi_Socket2Heart "AT+ETH_CH2HTP="

#define WiFi_SocketUDPClient "UDPC"
#define WiFi_SocketUDPServer "UDPS"
#define WiFi_SocketTCPClient "TCPC"
#define WiFi_SocketTCPServer "TCPS"

/* Exported functions --------------------------------------------------------*/
void WiFi_Init(uint8_t *pTransmitData, uint8_t *pReceiveData);
void WiFi_TransmitByte(uint8_t data);
void WiFi_TransmitString(uint16_t length, uint16_t nTime);
uint8_t WiFi_ReceiveByte(void);
uint16_t WiFi_ReceiveString(uint16_t nTime);

#ifdef __cplusplus
}
#endif

#endif

/***********************************END OF FILE********************************/
