InsanityBy/SmartPublicBathroom/Project/1_ShowerTerminal/Software/1_Library/Delay.c

/**
 ******************************************************************************
 * @file    Delay.c
 * @author  Ma boyang
 * @version V1.0
 * @date    2022.5.7
 * @brief   This file contains all the functions of delay using systick.(For
 *         shower terminal.)
 ******************************************************************************
 */

/* Includes ------------------------------------------------------------------*/
#include "Delay.h"

/* Private typedef -----------------------------------------------------------*/
/* Private define ------------------------------------------------------------*/
/* Private macro -------------------------------------------------------------*/
/* Private variables ---------------------------------------------------------*/
/* Private function prototypes -----------------------------------------------*/
/* Private functions ---------------------------------------------------------*/
/**
 * @brief  Delay n us.
 * @param  n: Delay n us.
 * @retval None.
 */
void Delay_us(uint32_t n)
{
    SysTick->LOAD = (SystemCoreClock / 1000000) * n / 8; // Reload value, SysTick clock is HCLK/8
    SysTick->VAL = 0x00000000;                     // Clear current value
    SysTick->CTRL = 0x00000001;                    // Enable counter
    uint32_t temp = SysTick->CTRL;                 // Get current CTRL value
    while ((temp & 0x01) && (!(temp & (1 << 16)))) // Wait till 0
    {
        temp = SysTick->CTRL;
    }
    SysTick->CTRL = 0x00000000; // Disable counter
    SysTick->VAL = 0x00000000;  // Clear current value
}

/**
 * @brief  Delay n ms.
 * @param  n: Delay n ms.
 * @retval None.
 */
void Delay_ms(uint32_t n)
{
    SysTick->LOAD = (SystemCoreClock / 1000) * n / 8;    // Reload value, SysTick clock is HCLK/8
    SysTick->VAL = 0x00000000;                     // Clear current value
    SysTick->CTRL = 0x00000001;                    // Enable counter
    uint32_t temp = SysTick->CTRL;                 // Get current CTRL value
    while ((temp & 0x01) && (!(temp & (1 << 16)))) // Wait till 0
    {
        temp = SysTick->CTRL;
    }
    SysTick->CTRL = 0x00000000; // Disable counter
    SysTick->VAL = 0x00000000;  // Clear current value
}

/**
 * @brief  Delay n s.
 * @param  n: Delay n s.
 * @retval None.
 */
void Delay_s(uint32_t n)
{
    while(n--)
    {
        Delay_ms(1000);
    }
}

/***********************************END OF FILE********************************/
