InsanityBy/SmartPublicBathroom/Project/2_ShowerHost/Software/1_Library/TemperatureHumidity.h

/**
 ******************************************************************************
 * @file    TemperatureHumidity.h
 * @author  Ma Boyang
 * @version V1.0
 * @date    2022.5.9
 * @brief   This file contains all the functions prototypes for temperature - 
 *          humidity sensor.
 ******************************************************************************
 */

/* Define to prevent recursive inclusion -------------------------------------*/
#ifndef __TEMPERATUREHUMIDITY_H
#define __TEMPERATUREHUMIDITY_H

#ifdef __cplusplus
extern "C"
{
#endif

/* Includes ------------------------------------------------------------------*/
#include "stm32f4xx.h"

/* Exported types ------------------------------------------------------------*/
/* Exported constants --------------------------------------------------------*/
/* Exported macro ------------------------------------------------------------*/
/* Exported functions --------------------------------------------------------*/
// Temperature - humidity sensor initialize
uint8_t TemperatureHumiditySensor_Init(void);

// Start convert
void Sensor_Convert(void);

// Get temperature
float Sensor_GetTemperature(void);

// Get humidity
float Sensor_GetHumidity(void);

#ifdef __cplusplus
}
#endif

#endif

/*****************************END OF FILE*****************************/
