InsanityBy/SmartPublicBathroom/(commit log)

2022-04-16 Create project file and add files of first state.
    [02i31889.drl, 02i31889.gbl, 02i31889.gbo, 02i31889.gbp, 02i31889.gbs, 02i31889.gtl, 02i31889.gto, 02i31889.gtp]
2022-04-16 Change file name and delete extra reference.
    [02i31889.drl, 02i31889.gbl, 02i31889.gbo, 02i31889.gbp, 02i31889.gbs, 02i31889.gtl, 02i31889.gto, 02i31889.gtp]
2022-04-16 Create design review document and modify some detailed design document.
    [ShowerHost.opj, ShowerTerminal.opj]
2022-04-17 Modify file directory, improve and modify report sections.
    [02i31889.drl, 02i31889.gbl, 02i31889.gbo, 02i31889.gbp, 02i31889.gbs, 02i31889.gtl, 02i31889.gto, 02i31889.gtp]
2022-04-17 Modify file directory, modify schematic, genereate BOM.
    [02i31889.drl, 02i31889.gbl, 02i31889.gbo, 02i31889.gbp, 02i31889.gbs, 02i31889.gtl, 02i31889.gto, 02i31889.gtp]
2022-04-18 Modify documents.
    [02i31889.drl, 02i31889.gbl, 02i31889.gbo, 02i31889.gbp, 02i31889.gbs, 02i31889.gtl, 02i31889.gto, 02i31889.gtp]
2022-04-20 Modify schematic, documents, references and designs.
    [A40-C2G4A04S1a_pad.pcbdoc, A40-C2G4A04S2a_3a_pad.pcbdoc, COMMUNICATE.OLB, D14.step, DHT21.OLB, DS18B20.OLB, Host_BOM.xlsx, IR-56384.OLB]
2022-04-22 Add .gitignore.
    [SHOWERHOST.DSN, SHOWERTERMINAL.DSN, showerhost.opj, showerterminal.opj]
2022-04-24 Add PCB footprint to schematics.
    [SHOWERHOST.DSN, SHOWERTERMINAL.DSN, showerhost.opj, showerterminal.opj]
2022-04-24 add a picture
    [showerterminal.opj]
2022-04-25 Modify pin number
    [SHOWERHOST.DSN, SHOWERTERMINAL.DSN, cap-smd_bd6_3-l6_6-w6_6-ls7_2-r-rd.psm, do-41_bd2_4-l4_7-p8_70-d0_6-rd.psm, key-th_4p-l6_2-w6_2-p4_50-ls6_5.psm, led-th_bd5_9-p2_54-fd.psm, led-th_bd6_2-p2_54-rd.psm, led0805-rd.psm]
2022-04-25 Add netlist
    [SHOWERHOST.DSN, SHOWERTEREMINAL.brd, SHOWERTERMINAL.DSN, cases.cfg, showerhost.opj, showerterminal.opj]
2022-04-25 Assign pins and regenerate BOM.
    [Host_BOM.xlsx, SHOWERHOST.DSN, SHOWERTERMINAL.DSN, Terminal_BOM.xlsx, showerhost.opj, showerterminal.opj]
2022-04-26 Modify netlist & add mechanical hole
    [SHOWERHOST.DSN, SHOWERTEREMINAL.brd, SHOWERTERMINAL.DSN, cases.cfg, showerhost.opj, showerterminal.opj]
2022-04-27 Modify schematic of shower terminal, using 2x2p CON.
    [SHOWERTERMINAL.DSN, showerhost.opj, showerterminal.opj]
2022-04-27 Update netlist
    [SHOWERHOST.DSN, SHOWERTERMINAL.DSN, conn-th_4p-p2_54_dealon_dw254w-22-04-85.psm, hdr-th_3p-p2_54-h-f-w8_6.psm, led-th_bd3_0-p2_54-fd.psm, showerhost.opj, showerterminal.opj]
2022-04-27 Create PCB layout design and bottom enclosure design.
    [showerterminal.opj]
2022-04-29 Add SHWERHOST.brd Version 1
    [SHOWERHOST.brd, cases.cfg, s24-pad.psm, showerhost.opj]
2022-04-30 Modify some components, update footprint and library.
    [SHOWERHOST.DSN, SHOWERTERMINAL.DSN, conn-th_3p-p2_50_hx25003-3wap.psm, showerhost.opj, showerterminal.opj, sw-th_4p-l6_0-w6_0-p4_50-ls6_5.psm]
2022-04-30 Modify PCB layout.
2022-05-01 Regenerate BOM and schematic PDF.
    [SHOWERHOST.DSN, SHOWERTERMINAL.DSN, ShowerHost_BOM.xlsx, ShowerTerminal_BOM.xlsx, showerterminal.opj]
2022-05-03 Update SHOWERHOST_PCB Ver1 & Add SHOWERTERMINAL_PCB Ver1
    [SHOWERHOST.DSN, SHOWERHOST.brd, SHOWERTERMINAL.brd, cases.cfg, led-th_bd5_9-p2_54-fd.psm, showerhost.opj, showerterminal.opj]
2022-05-03 Modify enclosure design.
2022-05-03 Conflict fix.
    [SHOWERHOST.DSN, showerhost.opj, showerterminal.opj]
2022-05-05 Add gerber files of two board
    [SHOWERHOST.brd, SHOWERTERMINAL.brd, art_param.txt, nc_param.txt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]
2022-05-07 Create software project, add code for temperature sensor.
2022-05-08 Add code for flow meter.
2022-05-08 Add code for button, signal output.
2022-05-09 Add code for temperature - humidity sensor.
2022-05-09 Add code for light sensor.
2022-05-14 Add code for infrared sensors.
2022-05-19 Modify Terminal board
    [SHOWERTERMINAL.brd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]
2022-05-19 Modify Host Schematic
    [SHOWERHOST.DSN, showerhost.opj]
2022-05-19 Add code for ZigBee and WiFi, add code for audio device and modify schematic of shower host WiFi part.
    [SHOWERHOST.DSN, showerhost.opj]
2022-05-25 Modify code for communicate, button audio and display.
